vtmkhoi/Perpetual-Calendar/Docs/Schematic.JPG

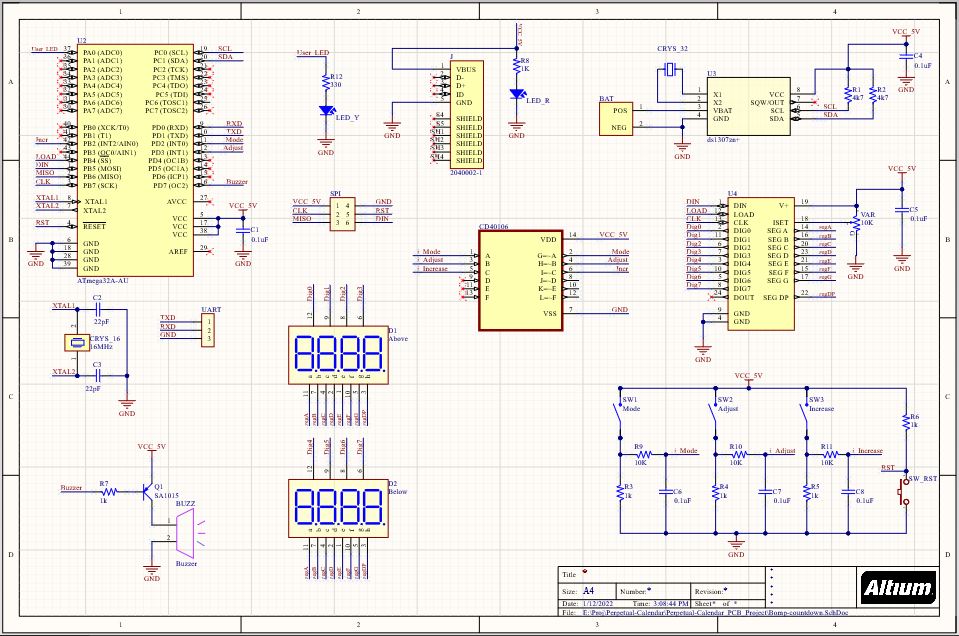
Docs/Schematic.JPG
