vtmkhoi/Perpetual-Calendar/Docs/Testboard.JPG

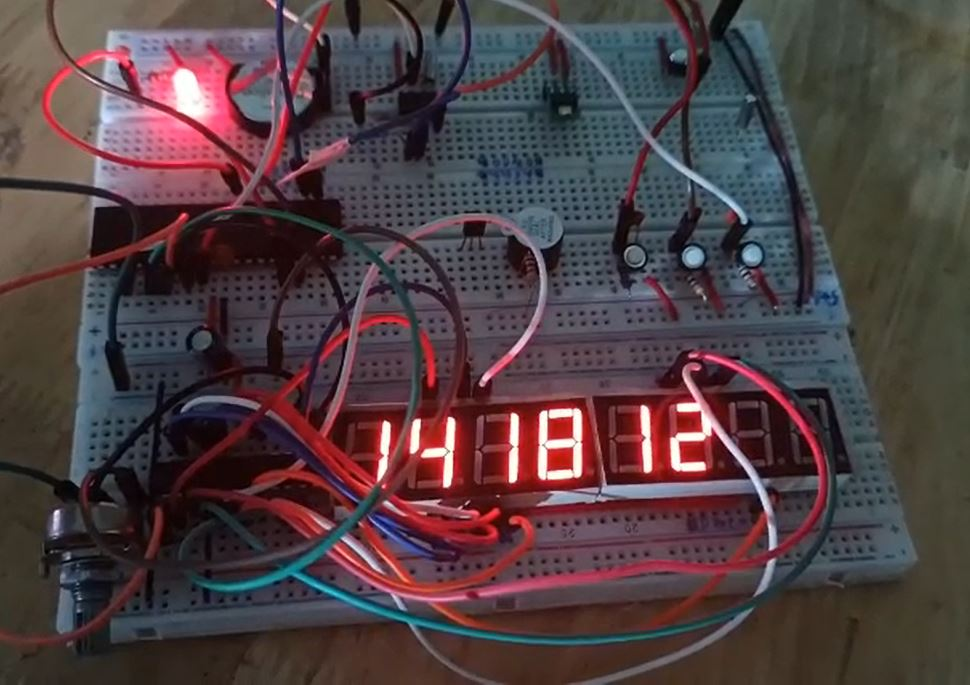
Docs/Testboard.JPG
