vtmkhoi/Perpetual-Calendar/README.md

# Perpetual-Calendar
Create a perpetual calendar using microcontroller AVR8bits, displayed on 7-segments via IC Max7219

# Have done
 - Interface Atmega32 with MAX7219
 - Interface Atmega32 with DS1307	
 - Algorithm for perpetual calendar
 - Adjust hour; minutes; day; month
 - Design PCB layout
 - Fullfilled displayed with mentor's requirements

# Haven't done
 - Blynk 7segments LED in Adjust's mode
<<<<<<< HEAD
 - revenge noise from button and SPI protocal
=======
 - Decrease noise from button and SPI protocal
>>>>>>> 75059a2ca367e3f0e033ad3231786ee3f7a5212f
