vtmkhoi/Perpetual-Calendar/Docs/2D_PCB_Bottom-layer.JPG

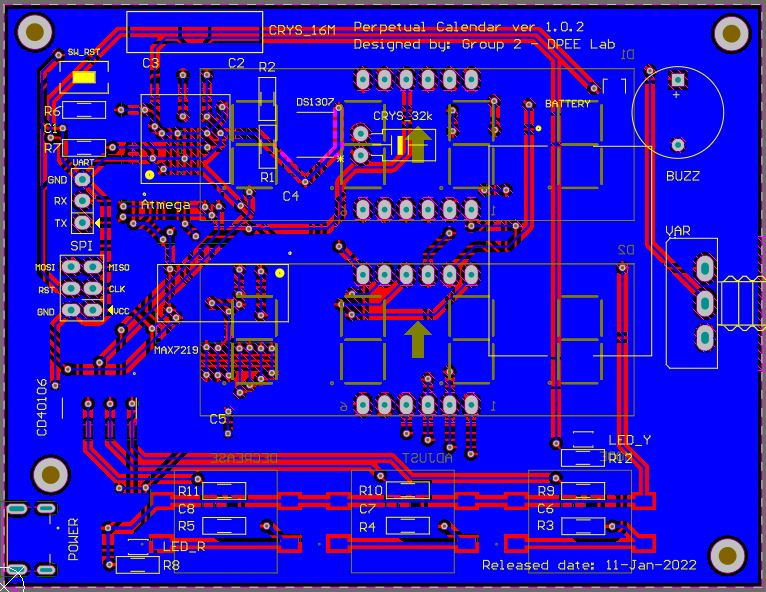
Docs/2D_PCB_Bottom-layer.JPG
