vtmkhoi/Perpetual-Calendar/Docs/2D_PCB_Top-layer.JPG

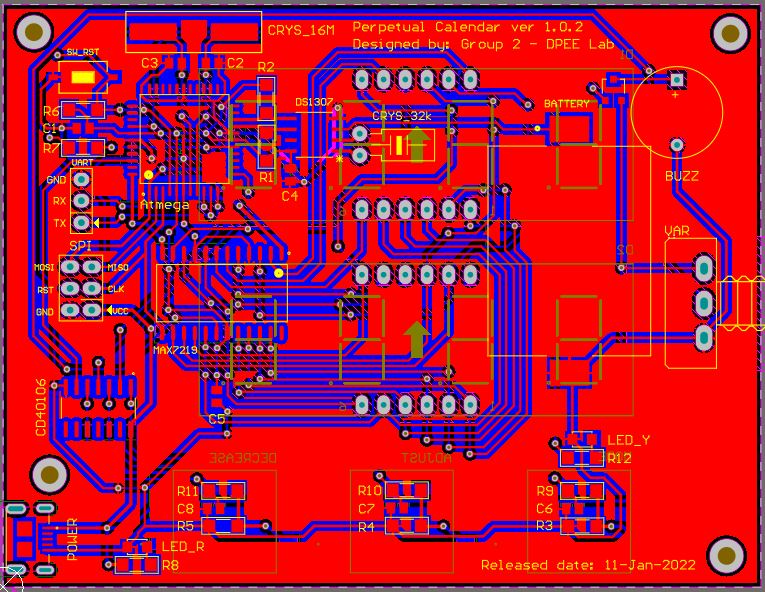
Docs/2D_PCB_Top-layer.JPG
