vtmkhoi/Perpetual-Calendar/Docs/3D_PCB_Bottom-layer.jpg

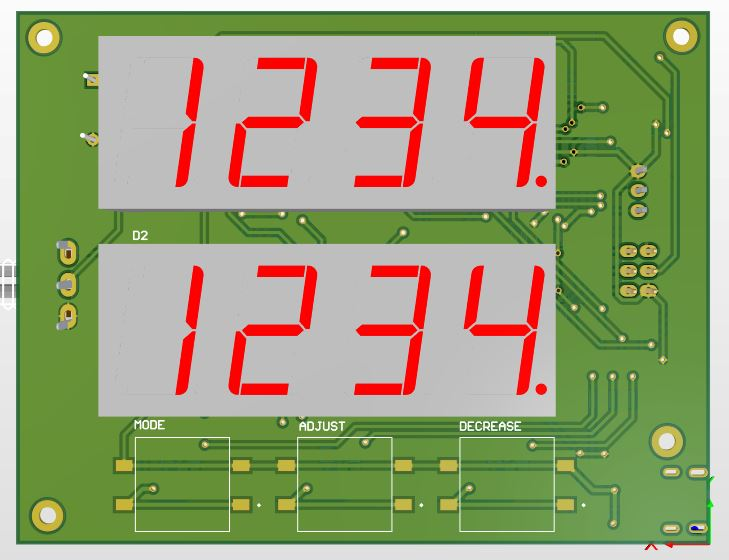
Docs/3D_PCB_Bottom-layer.jpg
