vtmkhoi/Perpetual-Calendar/Docs/3D_PCB_Top-layer.jpg

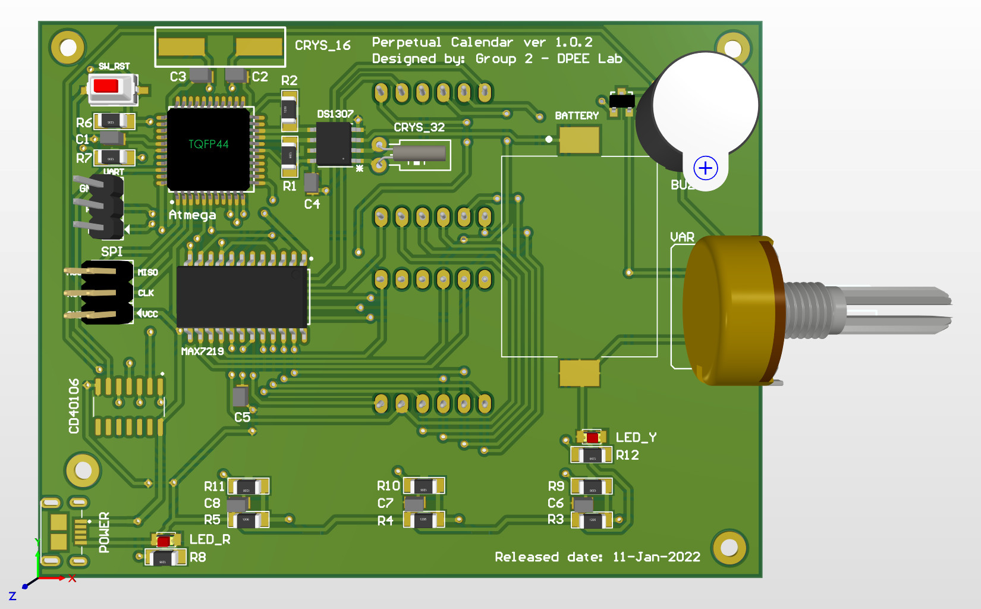
Docs/3D_PCB_Top-layer.jpg
