vtmkhoi/Perpetual-Calendar/Docs/40106.JPG

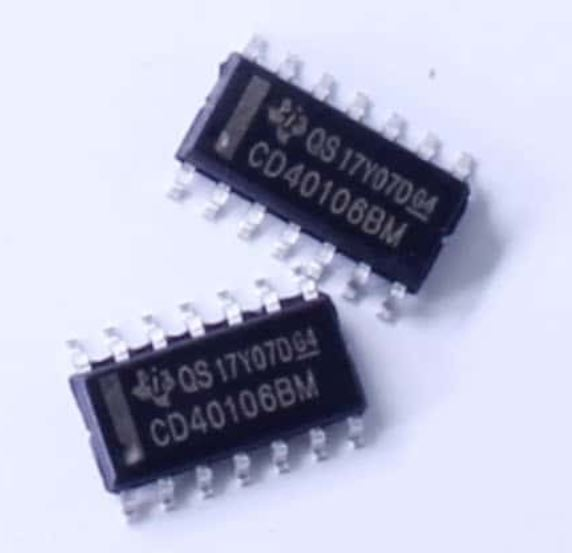
Docs/40106.JPG
