vtmkhoi/Perpetual-Calendar/Docs/Atmega32.jpg

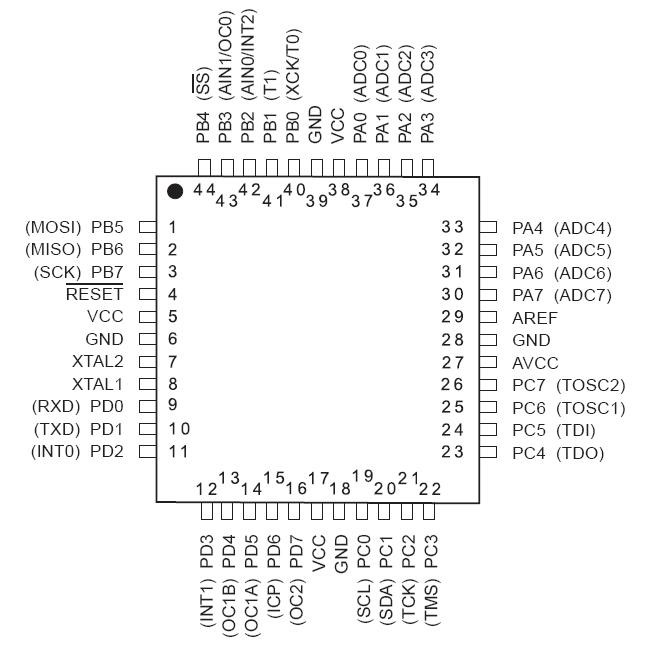
Docs/Atmega32.jpg
