vtmkhoi/Perpetual-Calendar/Docs/bouncing_1.jpg

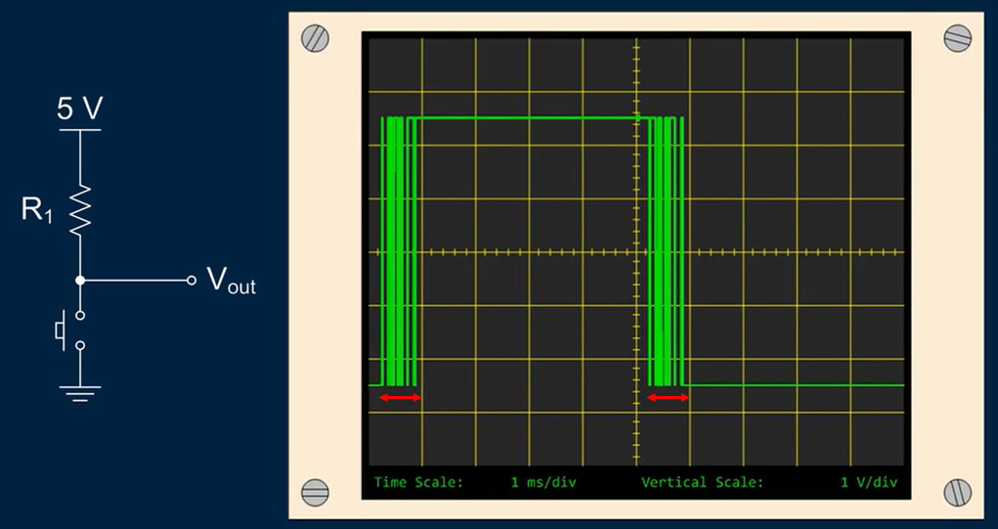
Docs/bouncing_1.jpg
