vtmkhoi/Perpetual-Calendar/Docs/DS1307.jpg

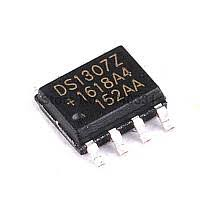
Docs/DS1307.jpg
