vtmkhoi/Perpetual-Calendar/Docs/MAX7219-2.JPG

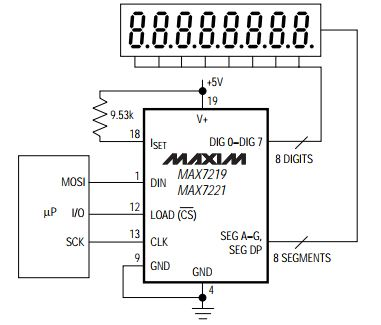
Docs/MAX7219-2.JPG
