vtmkhoi/Perpetual-Calendar/Docs/MAX7219.JPG

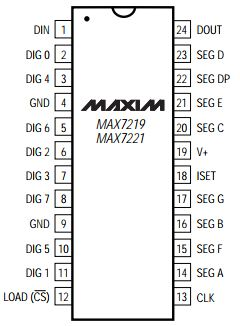
Docs/MAX7219.JPG
