vtmkhoi/Perpetual-Calendar/Docs/Mode_1.jpg

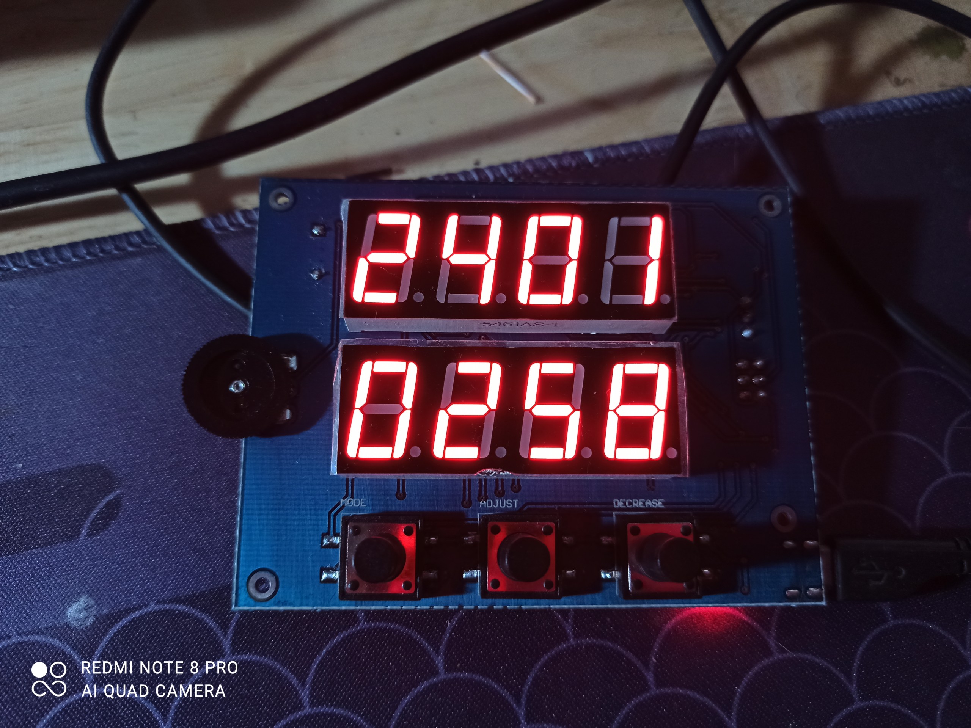
Docs/Mode_1.jpg
