vtmkhoi/Perpetual-Calendar/Docs/Mode_2.jpg

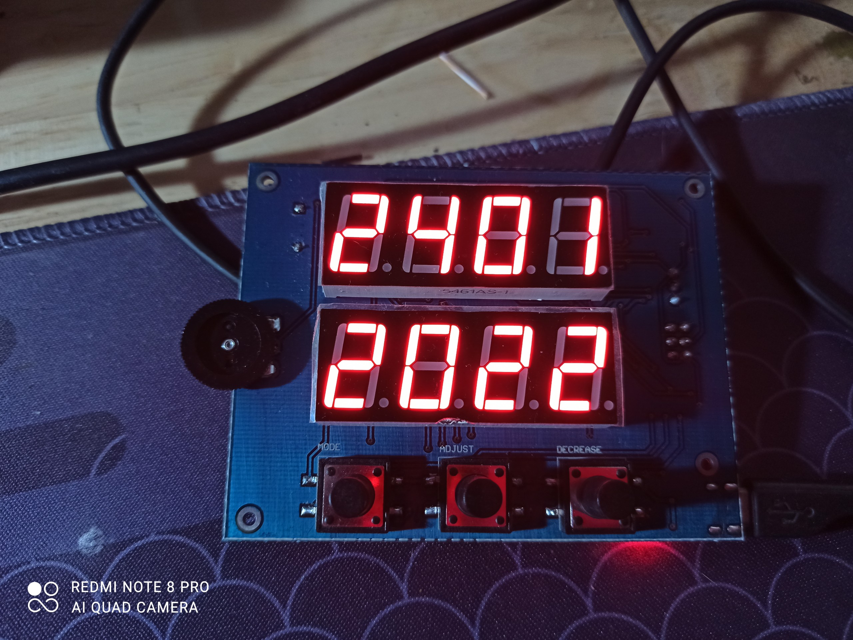
Docs/Mode_2.jpg
