vtmkhoi/Perpetual-Calendar/Docs/Mode_3.jpg

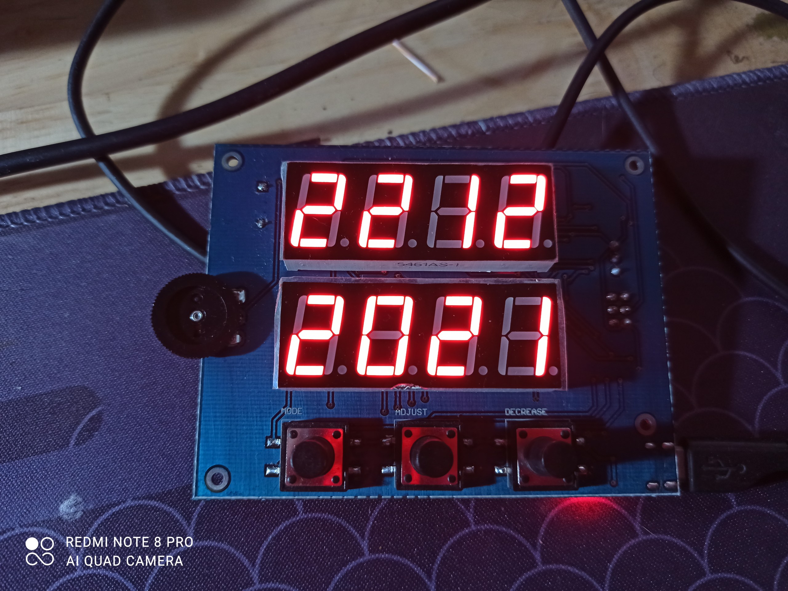
Docs/Mode_3.jpg
