vtmkhoi/Perpetual-Calendar/Components_list.xlsx

NO. | Name | Number | Type | Size | Link
1 | Atmega32 | 1 | DIP
2 | Atmega16A | 1 | SMD
3 | MAX7219 | 1 | SMD
4 | DS1307 | 2 | SMD
5 | Micro-USB | 3 | SMD
6 | Res 330 | 1 | SMD | 1206
7 | Res 4.7K |  | SMD | 1206
8 | Res 10K |  | SMD | 1206
9 | Cap 100nF = 0.1uF |  | SMD | 0805
10 | Cap 22pF |  | SMD | 0805
11 | Buzzer | 2 | SMD |  | SBZ-9032 Buzzer SMD 9.0x3.2mm 2700Hz 92dB, Nguồn: 3~5VDC (thegioiic.com) (https://www.thegioiic.com/products/sbz-9032-buzzer-smd-9-0x3-2mm-2700hz-92db)
12 | Transistor PNP 50V 0.15A | 5 | SMD |  | https://www.thegioiic.com/products/2sa1015lt1-ba-transistor-pnp-50v-0-15a-3-chan-sot-23
13 | Button | 6 | SMD |  | https://www.thegioiic.com/products/nut-nhan-12x12mm-cao-13mm-4-chan-smd
14 | Led RED | 10 | SMD | 0805
15 | Led BLUE | 10 | SMD | 0805
16 | Biến trở bánh xe 50K | 2 | DIP
