vtmkhoi/Perpetual-Calendar/(list of files, drawings)

Other design files:
Hardware/Altium/Bomp-countdown.SchDoc
Hardware/Altium/PCB1.PcbDoc
Hardware/Altium/PCB2.PcbDoc
Hardware/Altium/Perpetual-Calendar_PCB_Project.PrjPcb
