vtmkhoi/Perpetual-Calendar/Hardware/Kicad/PerpetualCalendar/PerpetualCalendar.kicad_pcb

## KiCad design Hardware/Kicad/PerpetualCalendar/PerpetualCalendar.kicad_pcb (2022-09-10)

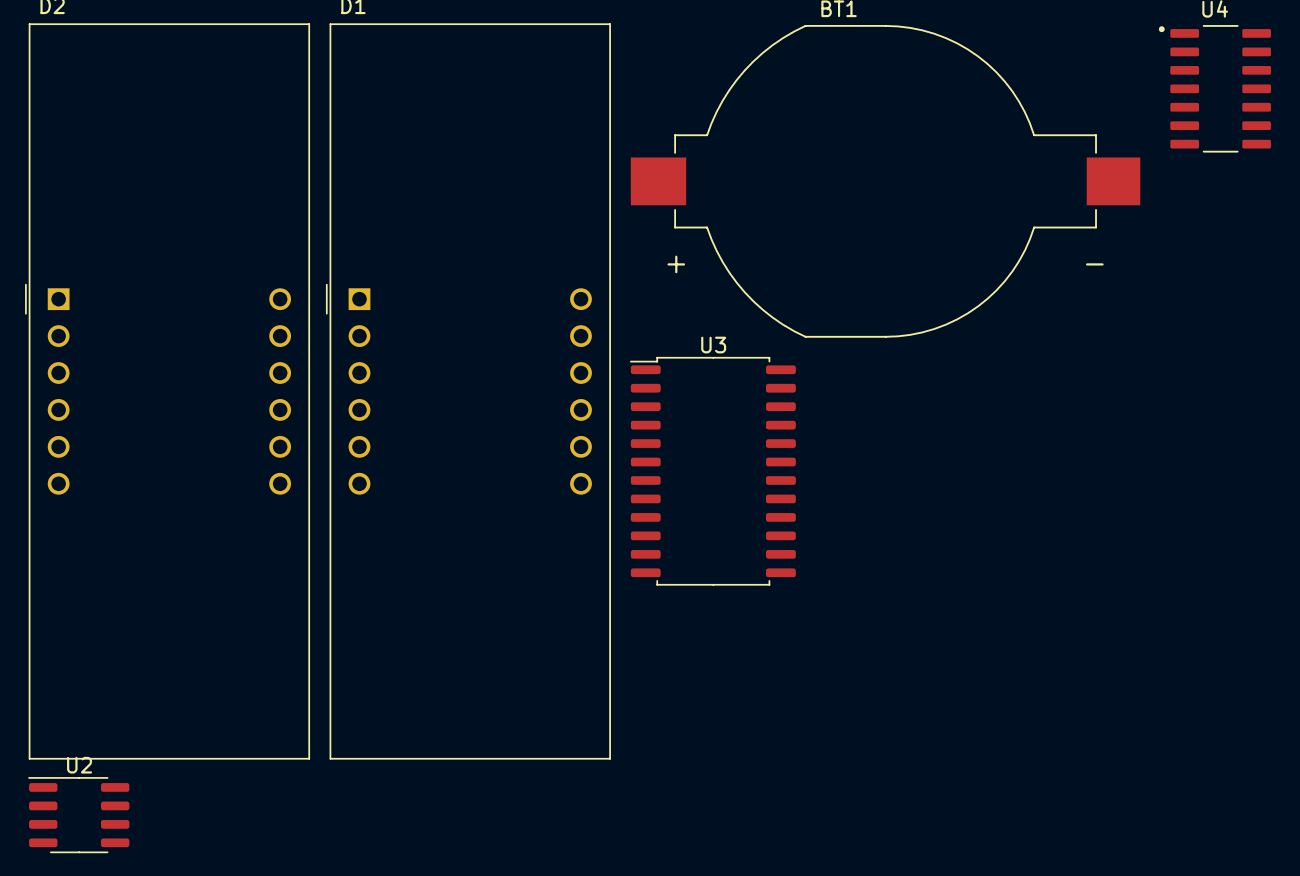
[picture p24: board PerpetualCalendar.kicad_pcb from above]

Board: 2 copper layers, 6 parts (0 on the bottom side), 18 nets, no tracks yet.

Parts:
BT1: Battery_Cell; BAT_BC2032-F1
D1: ABOVE; CA56-12CGKWA
D2: BELOW; CA56-12CGKWA
U2: DS1307Z+; SOIC-8_3.9x4.9mm_P1.27mm
U3: MAX7221; SOIC-24W_7.5x15.4mm_P1.27mm
U4: CD40106; SOIC127P600X175-14N

Connections:
/DIG0: D1.12 (CC1), U3.2 (DIG_0)
/DIG1: D1.9 (CC2), U3.11 (DIG_1)
/DIG2: D1.8 (CC3), U3.6 (DIG_2)
/DIG3: D1.6 (CC4), U3.7 (DIG_3)
/DIG4: D2.12 (CC1), U3.3 (DIG_4)
/DIG5: D2.9 (CC2), U3.10 (DIG_5)
/DIG6: D2.8 (CC3), U3.5 (DIG_6)
/DIG7: D2.6 (CC4), U3.8 (DIG_7)
/SEG_A: D1.11 (a), D2.11 (a)
/SEG_B: D1.7 (b), D2.7 (b)
/SEG_C: D1.4 (c), D2.4 (c)
/SEG_D: D1.2 (d), D2.2 (d)
/SEG_DP: D1.3 (DPX), D2.3 (DPX)
/SEG_E: D1.1 (e), D2.1 (e)
/SEG_F: D1.10 (f), D2.10 (f)
/SEG_G: D1.5 (g), D2.5 (g)
GND: U2.4 (GND), U4.7 (VSS)
unnamed: U3.4 (GND), U3.9 (GND)
