vtmkhoi/Perpetual-Calendar/(commit log)

2021-12-09 add file 3 buttons
    [PCB1.PcbDoc, Perpetual-Calendar_PCB.PrjPcb, Sheet1.SchDoc]
2021-12-14 add PCB layout
    [Perpetual-Calendar_PCB.PrjPcb, Sheet1.SchDoc]
2021-12-16 missed: 7seg, micro-usb
    [Perpetual-Calendar_PCB.PrjPcb, Sheet1.SchDoc]
2021-12-16 upd Readme, PCB-design
2021-12-17 add final version
    [Sheet1.SchDoc]
2021-12-17 update schematic
    [Sheet1.SchDoc]
2021-12-20 add Sche
    [PCB1.PcbDoc, Sheet1.SchDoc]
2021-12-22 add components list
    [Components_list.xlsx, Sheet1.SchDoc]
2021-12-24 edit sche
    [Bomp-countdown.SchDoc]
2021-12-25 add PCB design
    [Bomp-countdown.SchDoc, PCB1.PcbDoc, Perpetual-Calendar_PCB_Project.PrjPcb]
2021-12-27 add PCB
    [Bomp-countdown.SchDoc, PCB1.PcbDoc]
2022-01-05 add README
    [Bomp-countdown.SchDoc, Components_list.xlsx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]
2022-01-08 PCB ver01
2022-01-20 Last version
    [Bomp-countdown.SchDoc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]
2022-09-10 Update gitignore, Update schematic and some component's footprint
    [PerpetualCalendar.kicad_pcb, PerpetualCalendar.kicad_sch]
